aberhe-eng/SkyEar/images/pcb/pcb_3d_bottom.png

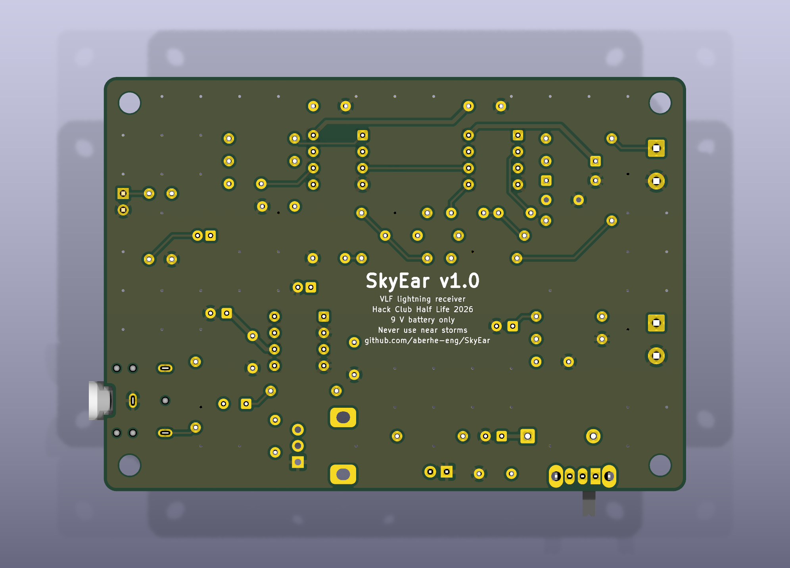
images/pcb/pcb_3d_bottom.png
