aberhe-eng/SkyEar/BOM.csv

Item | Qty | Supplier | Cost/item | Total Cost | link
Resistor 4.7k ohm 1/4W - YAGEO MFR-25FBF52-4K7 | 2 | DigiKey | $0.11 | $0.22 | https://www.digikey.com/en/products/result?keywords=MFR-25FBF52-4K7-ND
Resistor 10k ohm 1/4W - YAGEO MFR-25FBF52-10K | 10 | DigiKey | $0.04 | $0.40 | https://www.digikey.com/en/products/result?keywords=10.0KXBK-ND
Resistor 10M ohm (10 megohm) 1/4W - Stackpole CF14JT10M0 | 2 | DigiKey | $0.10 | $0.20 | https://www.digikey.com/en/products/result?keywords=CF14JT10M0CT-ND
Resistor 18k ohm 1/4W - YAGEO MFR-25FBF52-18K | 2 | DigiKey | $0.10 | $0.20 | https://www.digikey.com/en/products/result?keywords=MFR-25FBF52-18K-ND
Resistor 36k ohm 1/4W - YAGEO MFR-25FBF52-36K | 2 | DigiKey | $0.10 | $0.20 | https://www.digikey.com/en/products/result?keywords=13-MFR-25FBF52-36K-ND
Resistor 100k ohm 1/4W - YAGEO MFR-25FBF52-100K | 3 | DigiKey | $0.10 | $0.30 | https://www.digikey.com/en/products/result?keywords=100KXBK-ND
Resistor 3.3k ohm 1/4W - YAGEO MFR-25FBF52-3K3 | 2 | DigiKey | $0.10 | $0.20 | https://www.digikey.com/en/products/result?keywords=MFR-25FBF52-3K3-ND
Resistor 1k ohm 1/4W - YAGEO MFR-25FBF52-1K | 2 | DigiKey | $0.10 | $0.20 | https://www.digikey.com/en/products/result?keywords=1.00KXBK-ND
Resistor 10 ohm 1/4W - YAGEO MFR-25FBF52-10R | 2 | DigiKey | $0.10 | $0.20 | https://www.digikey.com/en/products/result?keywords=10.0XBK-ND
Resistor 47 ohm 1/4W - YAGEO MFR-25FBF52-47R | 2 | DigiKey | $0.10 | $0.20 | https://www.digikey.com/en/products/result?keywords=MFR-25FBF52-47R-ND
Electrolytic capacitor 100uF 25V - Panasonic ECA-1EM101I | 3 | DigiKey | $0.35 | $1.05 | https://www.digikey.com/en/products/result?keywords=10-ECA-1EM101ICT-ND
Ceramic capacitor 100nF 50V - TDK FG28X7R1H104KNT00 | 10 | DigiKey | $0.14 | $1.40 | https://www.digikey.com/en/products/result?keywords=445-FG28X7R1H104KNT00-ND
Electrolytic capacitor 47uF 50V - Panasonic ECA-1HM470 | 2 | DigiKey | $0.33 | $0.66 | https://www.digikey.com/en/products/result?keywords=P5181-ND
Ceramic capacitor 22pF 100V (C5 spare, not fitted) - TDK FG28C0G2A220JNT00 | 1 | DigiKey | $0.26 | $0.26 | https://www.digikey.com/en/products/result?keywords=445-175549-ND
Ceramic capacitor 10nF 50V C0G - TDK FG28C0G1H103JNT00 | 3 | DigiKey | $0.35 | $1.05 | https://www.digikey.com/en/products/result?keywords=FG28C0G1H103JNT00-ND
Ceramic capacitor 150pF 50V C0G - TDK FG28C0G1H151JNT00 | 2 | DigiKey | $0.22 | $0.44 | https://www.digikey.com/en/products/result?keywords=445-181753-ND
Ceramic capacitor 1uF 25V - TDK FG28X7R1E105KRT00 | 3 | DigiKey | $0.31 | $0.93 | https://www.digikey.com/en/products/result?keywords=445-181761-ND
Ceramic capacitor 2.2nF 50V C0G - TDK FG28C0G1H222JNT00 | 2 | DigiKey | $0.27 | $0.54 | https://www.digikey.com/en/products/result?keywords=445-FG28C0G1H222JNT00-ND
Ceramic capacitor 1nF 50V C0G - TDK FG28C0G1H102JNT00 | 2 | DigiKey | $0.25 | $0.50 | https://www.digikey.com/en/products/result?keywords=445-FG28C0G1H102JNT00-ND
Electrolytic capacitor 10uF 50V - KEMET ESK106M050AC3AA | 3 | DigiKey | $0.19 | $0.57 | https://www.digikey.com/en/products/result?keywords=399-6599-ND
Ceramic capacitor 47nF 50V - TDK FG28X7R1H473KNT00 | 2 | DigiKey | $0.23 | $0.46 | https://www.digikey.com/en/products/result?keywords=445-FG28X7R1H473KNT00-ND
Electrolytic capacitor 220uF 25V - Nichicon UVZ1E221MPD | 2 | DigiKey | $0.44 | $0.88 | https://www.digikey.com/en/products/result?keywords=493-1302-ND
Schottky diode 1N5817 (reverse-battery protection) - onsemi 1N5817G | 2 | DigiKey | $0.67 | $1.34 | https://www.digikey.com/en/products/result?keywords=1N5817GOS-ND
Red 5 mm LED (power light) - Kingbright WP7113ID | 2 | DigiKey | $0.21 | $0.42 | https://www.digikey.com/en/products/result?keywords=754-1264-ND
Diode 1N4148 (antenna input protection) - onsemi 1N4148 | 4 | DigiKey | $0.10 | $0.40 | https://www.digikey.com/en/products/result?keywords=1N4148FS-ND
TL072 dual JFET op-amp, DIP-8 - Texas Instruments TL072ACP | 3 | DigiKey | $1.50 | $4.50 | https://www.digikey.com/en/products/result?keywords=296-7190-5-ND
LM386 headphone amplifier, DIP-8 - Texas Instruments LM386N-1/NOPB | 2 | DigiKey | $1.18 | $2.36 | https://www.digikey.com/en/products/result?keywords=296-44414-5-ND
2-pin screw terminal 5.08 mm (battery, antenna) - Phoenix Contact 1715721 | 2 | DigiKey | $1.16 | $2.32 | https://www.digikey.com/en/products/result?keywords=277-1263-ND
3.5 mm headphone jack - Same Sky (CUI) SJ1-3523N | 1 | DigiKey | $1.12 | $1.12 | https://www.digikey.com/en/products/result?keywords=CP1-3523N-ND
2-pin header 2.54 mm (line out) - Sullins PREC002SAAN-RC | 1 | DigiKey | $0.10 | $0.10 | https://www.digikey.com/en/products/result?keywords=35-PREC002SAAN-RC-ND
Slide switch SPDT right-angle (power) - C&K OS102011MA1QN1 | 1 | DigiKey | $0.75 | $0.75 | https://www.digikey.com/en/products/result?keywords=CKN9559-ND
10k potentiometer (volume) - Alps Alpine RK09K1130AP5 | 1 | DigiKey | $1.70 | $1.70 | https://www.digikey.com/en/products/result?keywords=4809-RK09K1130AP5-ND
9V battery snap clip - Keystone 232 | 1 | DigiKey | $0.66 | $0.66 | https://www.digikey.com/en/products/result?keywords=36-232-ND
DIP-8 IC socket - Mill-Max 110-44-308-41-001000 | 3 | DigiKey | $0.99 | $2.97 | https://www.digikey.com/en/products/result?keywords=ED90048-ND
SkyEar PCB v1.0: 2-layer FR-4, 1.6 mm, 90 x 64 mm (Gerbers in pcb/gerbers) | 5 | JLCPCB | $0.40 | $2.00 | https://jlcpcb.com/quote
Estimated total shipping | 1 |  |  | $20.00
