aberhe-eng/SkyEar/JOURNAL.md

# Sky-Ear – devlog

<!-- Generated by Half Life from project cmuwsvtv10air01osvt94v5qg. Edits here are overwritten on the next sync. -->
<!-- Generated: 2026-10-11T19:29:52.596Z -->

> [!NOTE]
> This devlog is mirrored from [Half Life](https://halflife.hackclub.com) – [open the project](https://halflife.hackclub.com/projects/cmuwsvtv10air01osvt94v5qg). Editing it here will not change the platform's copy, and the next sync overwrites this file.

> A pocket radio that listens to lightning strikes thousands of miles away, plus the eerie whistling sounds lightning makes after bouncing along Earth's magnetic field through space. Basically a phone call from the planet.

| Week | Tier | Hours logged | Entries |
| --- | --- | --- | --- |
| Week 1 | Tier 2 | 28h | 2 |

## Contents

1. [2026-10-07 – I spent the first 3 hours learning how to use KiCad, specifically it's schematic editor. I followed a tutorial on building a beginner project, and learned how to use the editor along the way. The desi](#2026-10-07-i-spent-the-first-3-hours-learning-how-to-use-kic)
2. [2026-10-11 – This session was all about getting SkyEar's complete schematic into KiCad, which is the core of my Week 1 PCB design. Since my build guide already had every part, value and connection worked out block](#2026-10-11-this-session-was-all-about-getting-skyears-comple)

## Design

### 2026-10-07 – I spent the first 3 hours learning how to use KiCad, specifically it's schematic editor. I followed a tutorial on building a beginner project, and learned how to use the editor along the way. The desi

**13h**

I spent the first 3 hours learning how to use KiCad, specifically it's schematic editor. I followed a tutorial on building a beginner project, and learned how to use the editor along the way. The design in the image (which is the project from the tutorial) is based on the LM555 timer, which can blink a LED with a frequency that can be adjusted by the trimmer. This project let me understand the basics of making circuits, such as GND, Resistors, mounting holes, power sources, etc.





I then spent the remaining 10 hours drafting a full PDF for the SkyEar Project. The document includes a detailed parts list, the overall design of SkyEar, and small diagrams to help me understand how each section of the circuit connects together before I start drawing the final schematic.

SkyEar is divided into seven main blocks: power, virtual ground (VREF), antenna buffer, hum filter, gain stage, high-frequency filter, and outputs. Breaking the project into these blocks helped me understand the purpose of each part of the circuit instead of treating the entire schematic as one complicated design.

















I then spent some time doing more beginner projects, like a tutorial for making a traffic light:https://www.youtube.com/watch?v=EPH23zhPg50



I then learned how to make a 3D model of this schematic, which I have never done before. It took me a while but I eventually got the hang of it. I plan to do more projects learning how to use the 3D modeling tool





### 2026-10-11 – This session was all about getting SkyEar's complete schematic into KiCad, which is the core of my Week 1 PCB design. Since my build guide already had every part, value and connection worked out block

**15h**

This session was all about getting SkyEar's complete schematic into KiCad, which is the core of my Week 1 PCB design. Since my build guide already had every part, value and connection worked out block by block, I made the KiCad schematic directly from it. It came out as a single sheet with 52 parts, split into labeled sections that follow the signal from the antenna all the way to the headphones, and every part already has a real KiCad footprint assigned so it's ready for the PCB editor.





The power section takes a 9 V battery through a screw terminal (J1) and a slide switch (SW1), then through a 1N5817 Schottky diode (D1). The diode means plugging the battery in backwards can't fry anything, and I picked a Schottky because it only drops about 0.3 V instead of 0.7 V like a normal diode. C1 (100 µF) and C2 (100 nF) smooth out the supply, and a 4.7k resistor feeds a power LED at about 1.5 mA. Next to it is the virtual ground: two 10k resistors split the battery in half to make a ~4.35 V "VREF", with C3 and C4 keeping it quiet. Audio signals swing both above and below zero, but a single battery only gives 0 V and +9 V, so every op-amp signal swings around VREF instead.





The antenna input was the most interesting part to understand. A short wire antenna behaves like a tiny ~30 pF capacitor, so it can barely push any current. That's why R5 is 10 MΩ instead of a normal 10k, and why the first stage (U1A, half of a TL072) is a buffer that just copies the signal without loading it. The TL072 has JFET inputs, which is what lets it handle such a high resistance. R5 and the antenna capacitance also form the first filter, starting to cut hum below ~530 Hz. R4 and two 1N4148 diodes (D3, D4) protect the input by dumping static from the antenna into the power rails. C5 is marked "do not fit" and only gets soldered if I end up hearing AM radio.







After the buffer comes the hum filter (U1B), a 2nd-order high-pass at about 625 Hz built from two 10 nF caps, an 18k and a 36k. Making the 36k exactly twice the 18k gives a flat Butterworth response with no bump at the cutoff. Power lines put out 60 Hz hum that's thousands of times stronger than lightning on another continent, so this filter is what makes the whole thing usable. Then U2A amplifies the signal by 1 + 100k/3.3k ≈ 31. C9 keeps DC from getting amplified so the output stays centered on VREF, and C8 (150 pF) starts rolling off the highs. U2B is a 2nd-order low-pass at ~10.7 kHz that cuts hiss, AM radio, and the Navy's huge VLF transmitters around 20 to 25 kHz, which could otherwise overload everything.







The output splits two ways. The line out (J4) goes through a 10 µF cap and a 1k resistor so I can record the audio or feed it into my later Half Life projects. The headphone path goes through a 10k audio-taper volume knob (RV1) into an LM386 amp that adds another x20, so the total gain from antenna to ears is around 620. R14 and C17 (10 Ω + 47 nF) keep the LM386 from oscillating, C18 (220 µF) blocks DC from reaching my headphones, and R15 (47 Ω) caps the maximum volume so it can't blast my ears. Tip and ring on the jack are tied together so the mono signal goes to both ears.





For checking, the schematic passed KiCad's Electrical Rules Checker with 0 errors, every one of the 27 nets was compared against my guide, every footprint's pads were matched to its symbol's pins (the headphone jack's T/R/S pads were the one I was most worried about), and every electrolytic cap was checked to have its + side on the higher voltage. The project file also already has my track widths set: 0.6 mm for +9V and GND, and 0.3 mm for signals. [What you did yourself, e.g. "I opened it in KiCad on my own computer, re-ran the checker, fixed the 2 library warnings KiCad 10 shows with Update Symbols from Library, and traced the signal from J2 to J3 against my guide."]







One thing I still need to figure out is the budget. Tier 1 is $30 and my rough estimate is $35 to $50 once the PCB and the antenna are included, so my next step is pricing the real BOM. After that comes the PCB layout, where the main rule is keeping the antenna input as far as possible from the headphone amp so the loud output can't leak back into the input and squeal.
