aberhe-eng/SkyEar/pcb/skyear_schematic.pdf

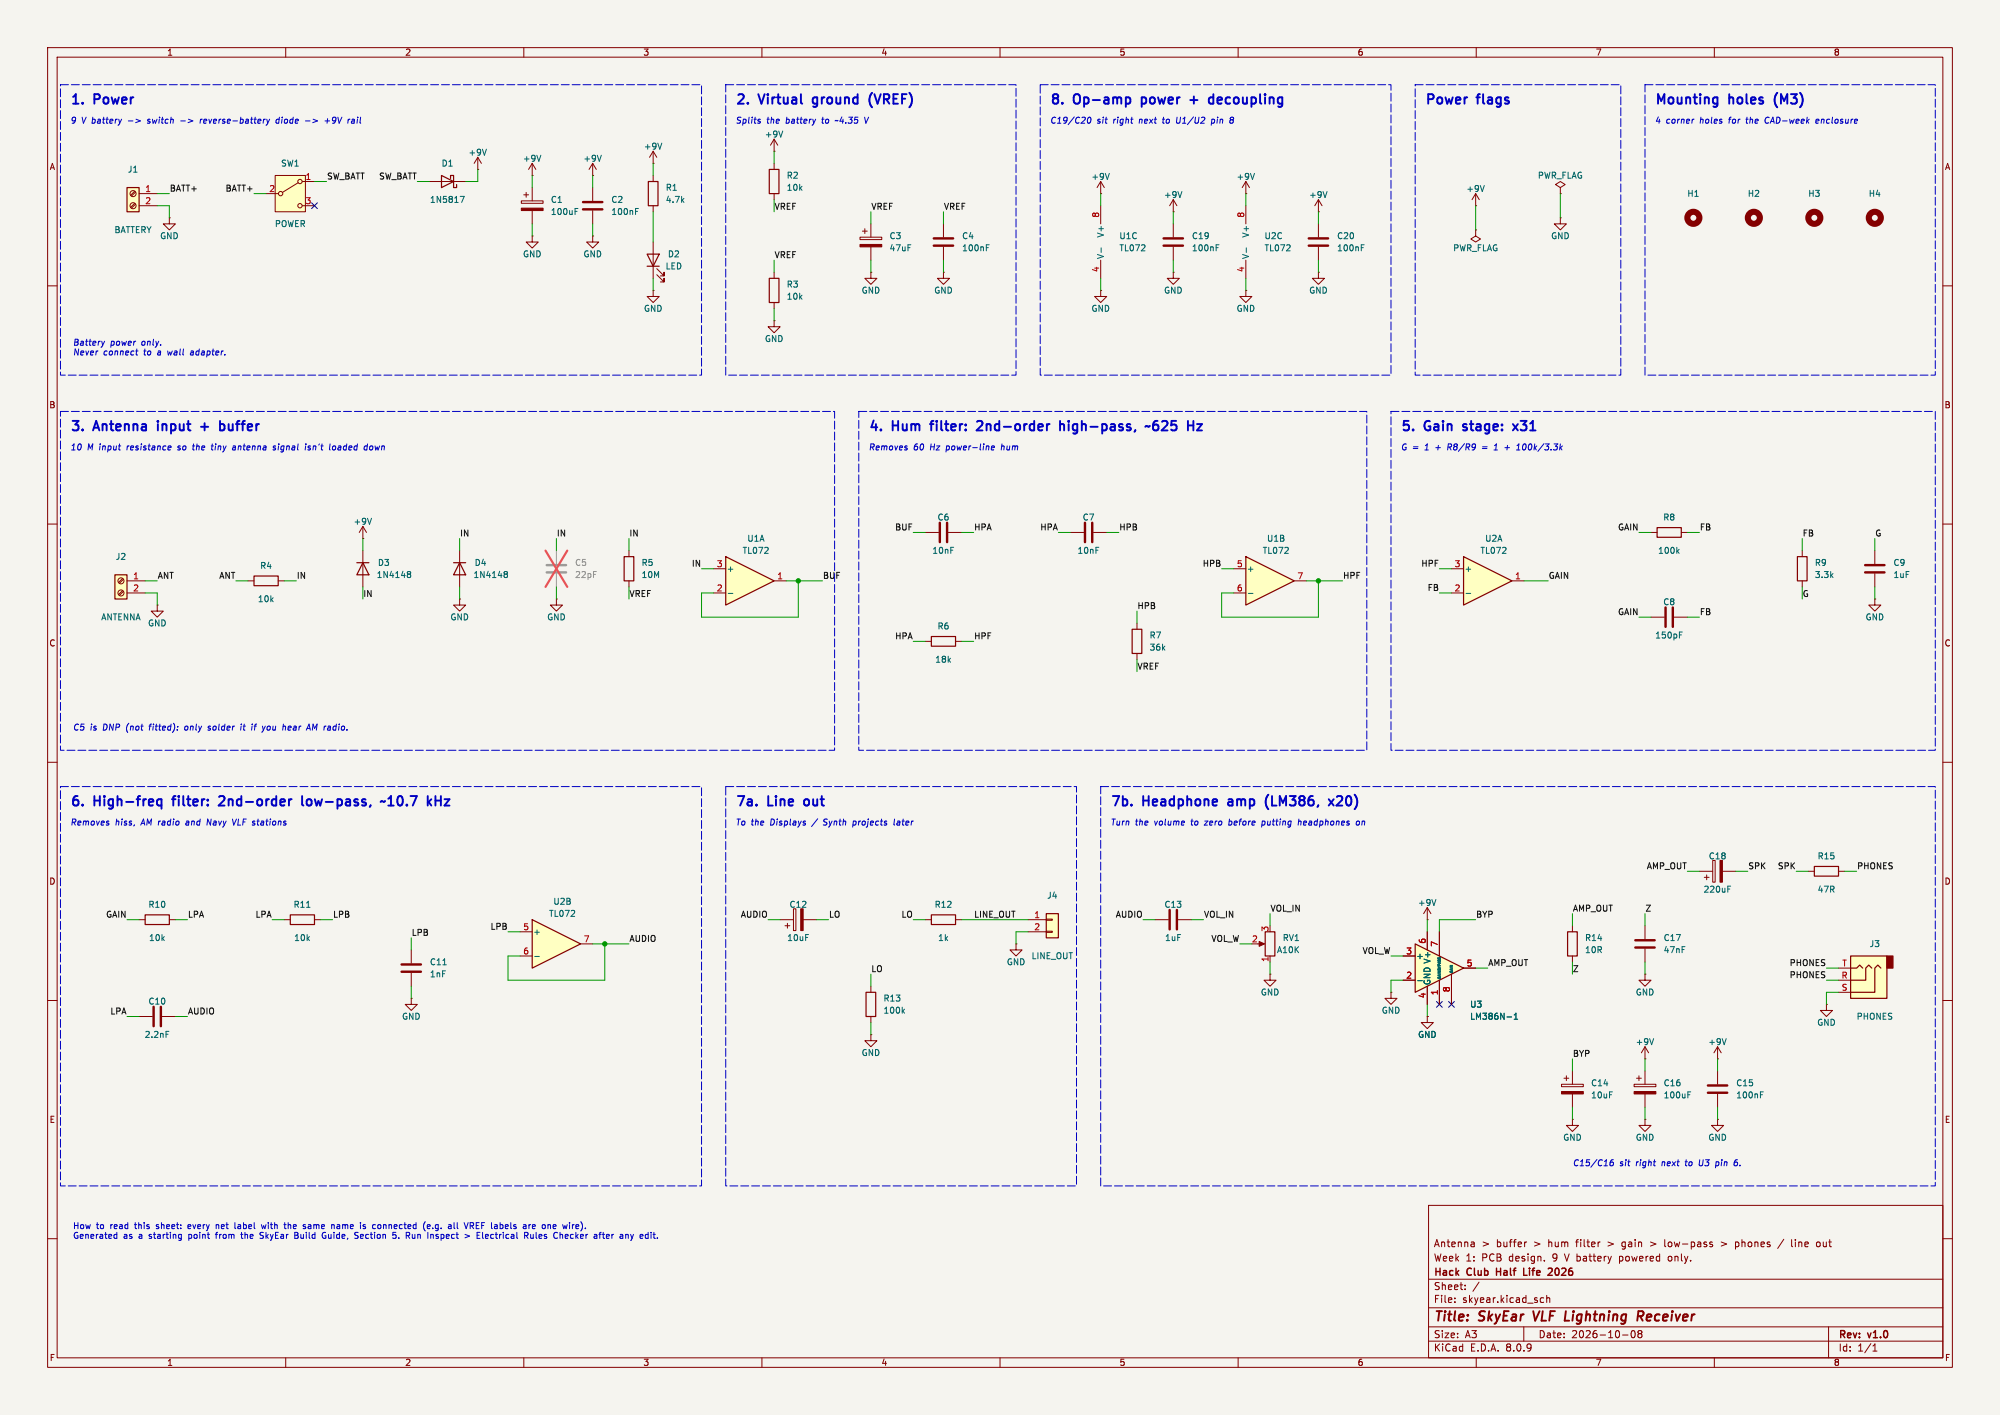
[picture p21: page 1]

Splits the battery to ~4.35 V 2. Virtual ground (VREF)

Battery power only. Never connect to a wall adapter.
