aberhe-eng/SkyEar/pcb/skyear.kicad_pcb

## KiCad design pcb/skyear.kicad_pcb (2026-10-11)

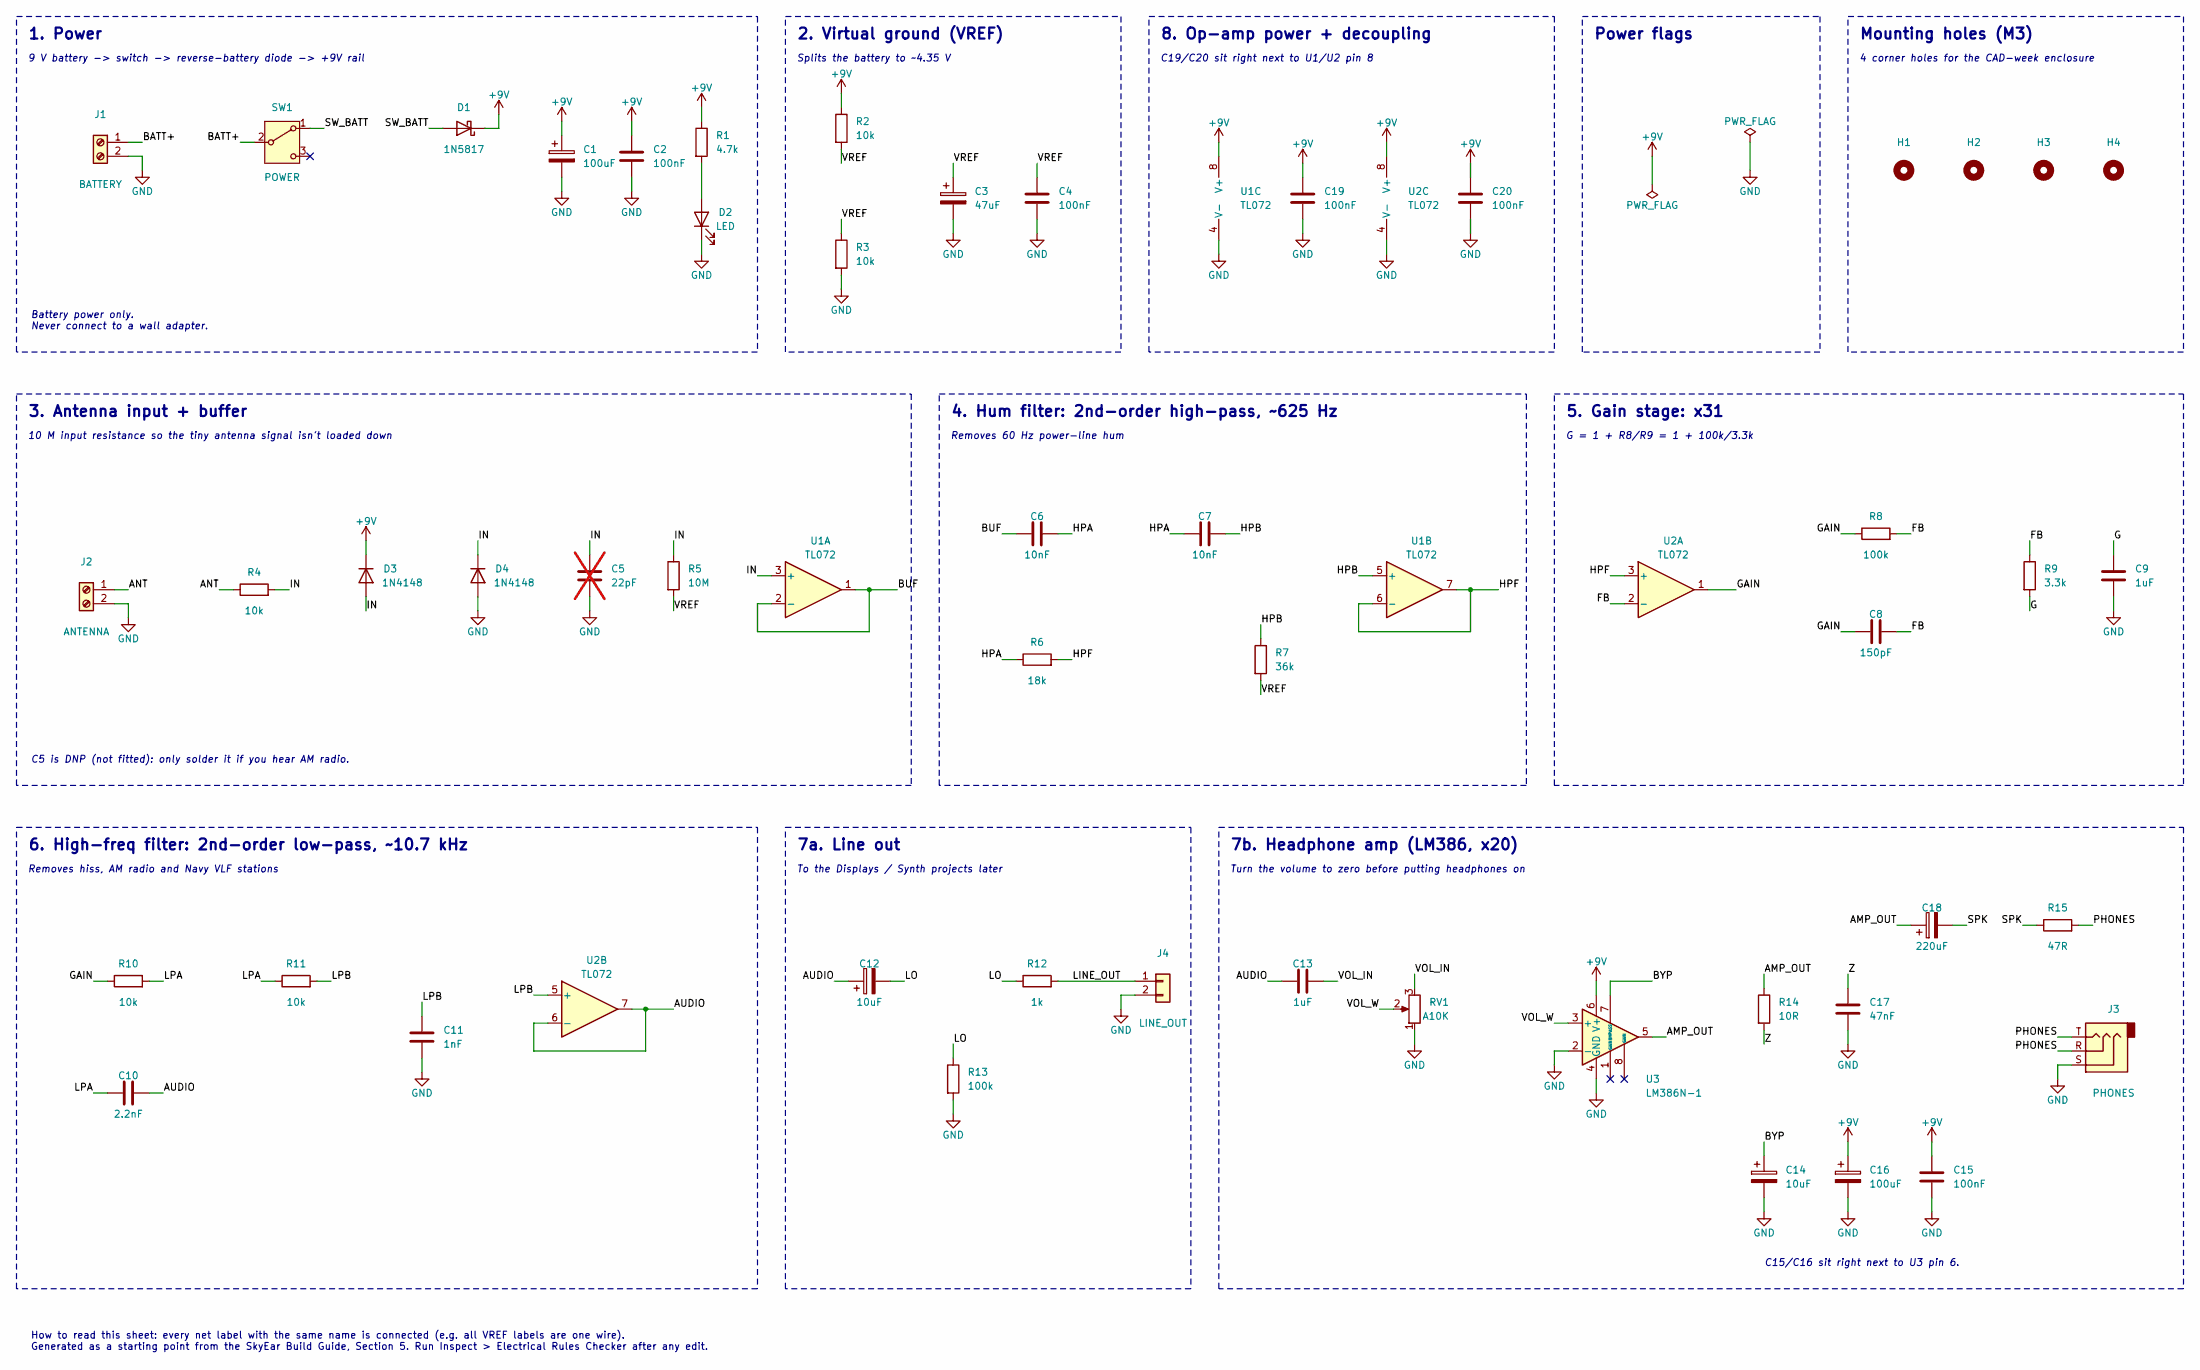
[picture p22: schematic skyear.kicad_sch, SkyEar VLF Lightning Receiver]

Parts:
C1, C16: 100uF; CP_Radial_D6.3mm_P2.50mm
C2, C4, C15, C19, C20: 100nF; C_Disc_D5.0mm_W2.5mm_P5.00mm
C3: 47uF; CP_Radial_D6.3mm_P2.50mm
C5: 22pF; C_Disc_D5.0mm_W2.5mm_P5.00mm; not fitted
C6, C7: 10nF; C_Disc_D5.0mm_W2.5mm_P5.00mm
C8: 150pF; C_Disc_D5.0mm_W2.5mm_P5.00mm
C9, C13: 1uF; C_Disc_D5.0mm_W2.5mm_P5.00mm
C10: 2.2nF; C_Disc_D5.0mm_W2.5mm_P5.00mm
C11: 1nF; C_Disc_D5.0mm_W2.5mm_P5.00mm
C12, C14: 10uF; CP_Radial_D5.0mm_P2.00mm
C17: 47nF; C_Disc_D5.0mm_W2.5mm_P5.00mm
C18: 220uF; CP_Radial_D8.0mm_P3.50mm
D1: 1N5817; D_DO-41_SOD81_P10.16mm_Horizontal
D2: LED; LED_D5.0mm
D3, D4: 1N4148; D_DO-35_SOD27_P7.62mm_Horizontal
H1, H2, H3, H4: MountingHole; MountingHole_3.2mm_M3
J1: BATTERY; TerminalBlock_Phoenix_MKDS-1,5-2-5.08_1x02_P5.08mm_Horizont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; MPN Phoenix MKDS 1,5/2-5,08 (or same 5.08 m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
J2: ANTENNA; TerminalBlock_Phoenix_MKDS-1,5-2-5.08_1x02_P5.08mm_Horizont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; MPN Phoenix MKDS 1,5/2-5,08 (or same 5.08 m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
J3: PHONES; Jack_3.5mm_CUI_SJ1-3523N_Horizontal; MPN CUI SJ1-3523N
J4: LINE_OUT; PinHeader_1x02_P2.54mm_Vertical
R1: 4.7k; R_Axial_DIN0207_L6.3mm_D2.5mm_P10.16mm_Horizontal
R2, R3, R4, R10, R11: 10k; R_Axial_DIN0207_L6.3mm_D2.5mm_P10.16mm_Horizontal
R5: 10M; R_Axial_DIN0207_L6.3mm_D2.5mm_P10.16mm_Horizontal
R6: 18k; R_Axial_DIN0207_L6.3mm_D2.5mm_P10.16mm_Horizontal
R7: 36k; R_Axial_DIN0207_L6.3mm_D2.5mm_P10.16mm_Horizontal
R8, R13: 100k; R_Axial_DIN0207_L6.3mm_D2.5mm_P10.16mm_Horizontal
R9: 3.3k; R_Axial_DIN0207_L6.3mm_D2.5mm_P10.16mm_Horizontal
R12: 1k; R_Axial_DIN0207_L6.3mm_D2.5mm_P10.16mm_Horizontal
R14: 10R; R_Axial_DIN0207_L6.3mm_D2.5mm_P10.16mm_Horizontal
R15: 47R; R_Axial_DIN0207_L6.3mm_D2.5mm_P10.16mm_Horizontal
RV1: A10K; Potentiometer_Alps_RK09K_Single_Vertical; MPN Alps RK09K series, 10k audio (A) taper
SW1: POWER; SW_Slide_SPDT_Angled_CK_OS102011MA1Q; MPN C&K OS102011MA1QN1 (right-angle)
U1, U2: TL072; DIP-8_W7.62mm_Socket
U3: LM386N-1; DIP-8_W7.62mm_Socket

Connections:
+9V: C1.1, C2.1, C15.1, C16.1, C19.1, C20.1, D1.1 (K), D3.1 (K), R1.1, R2.1, U1.8 (V+), U2.8 (V+), U3.6 (V+)
/AMP_OUT: C18.1, R14.1, U3.5
/ANT: J2.1, R4.1
/AUDIO: C10.2, C12.1, C13.1, U2.6 (-), U2.7
/BATT+: J1.1, SW1.2 (B)
/BUF: C6.1, U1.1, U1.2 (-)
/BYP: C14.1, U3.7 (BYPASS)
/FB: C8.2, R8.2, R9.1, U2.2 (-)
/G: C9.1, R9.2
/GAIN: C8.1, R8.1, R10.1, U2.1
/HPA: C6.2, C7.1, R6.1
/HPB: C7.2, R7.1, U1.5 (+)
/HPF: R6.2, U1.6 (-), U1.7, U2.3 (+)
/IN: C5.1, D3.2 (A), D4.1 (K), R4.2, R5.1, U1.3 (+)
/LINE_OUT: J4.1, R12.2
/LO: C12.2, R12.1, R13.1
/LPA: C10.1, R10.2, R11.1
/LPB: C11.1, R11.2, U2.5 (+)
/PHONES: J3.R, J3.T, R15.2
/SPK: C18.2, R15.1
/SW_BATT: D1.2 (A), SW1.1 (A)
/VOL_IN: C13.2, RV1.3
/VOL_W: RV1.2, U3.3 (+)
/VREF: C3.1, C4.1, R2.2, R3.1, R5.2, R7.2
/Z: C17.1, R14.2
GND: C1.2, C2.2, C3.2, C4.2, C5.2, C9.2, C11.2, C14.2, C15.2, C16.2, C17.2, C19.2, C20.2, D2.1 (K), D4.2 (A), J1.2, J2.2, J3.S, J4.2, R3.2, R13.2, RV1.1, U1.4 (V-), U2.4 (V-), U3.2 (-), U3.4 (GND)
unnamed: D2.2 (A), R1.2

Notes on the sheet:
1. Power
9 V battery -> switch -> reverse-battery diode -> +9V rail
Battery power only. Never connect to a wall adapter.
2. Virtual ground (VREF)
Splits the battery to ~4.35 V
8. Op-amp power + decoupling
C19/C20 sit right next to U1/U2 pin 8
Power flags
Mounting holes (M3)
4 corner holes for the CAD-week enclosure
3. Antenna input + buffer
10 M input resistance so the tiny antenna signal isn't loaded down
C5 is DNP (not fitted): only solder it if you hear AM radio.
4. Hum filter: 2nd-order high-pass, ~625 Hz
Removes 60 Hz power-line hum
5. Gain stage: x31
G = 1 + R8/R9 = 1 + 100k/3.3k
6. High-freq filter: 2nd-order low-pass, ~10.7 kHz
Removes hiss, AM radio and Navy VLF stations
7a. Line out
To the Displays / Synth projects later
7b. Headphone amp (LM386, x20)
Turn the volume to zero before putting headphones on
C15/C16 sit right next to U3 pin 6.
How to read this sheet: every net label with the same name is connected (e.g. all VREF labels are one wire). Generated as a starting point from the SkyEar Build Guide, Section 5. Run Inspect > Electrical Rules Checker after any edit.

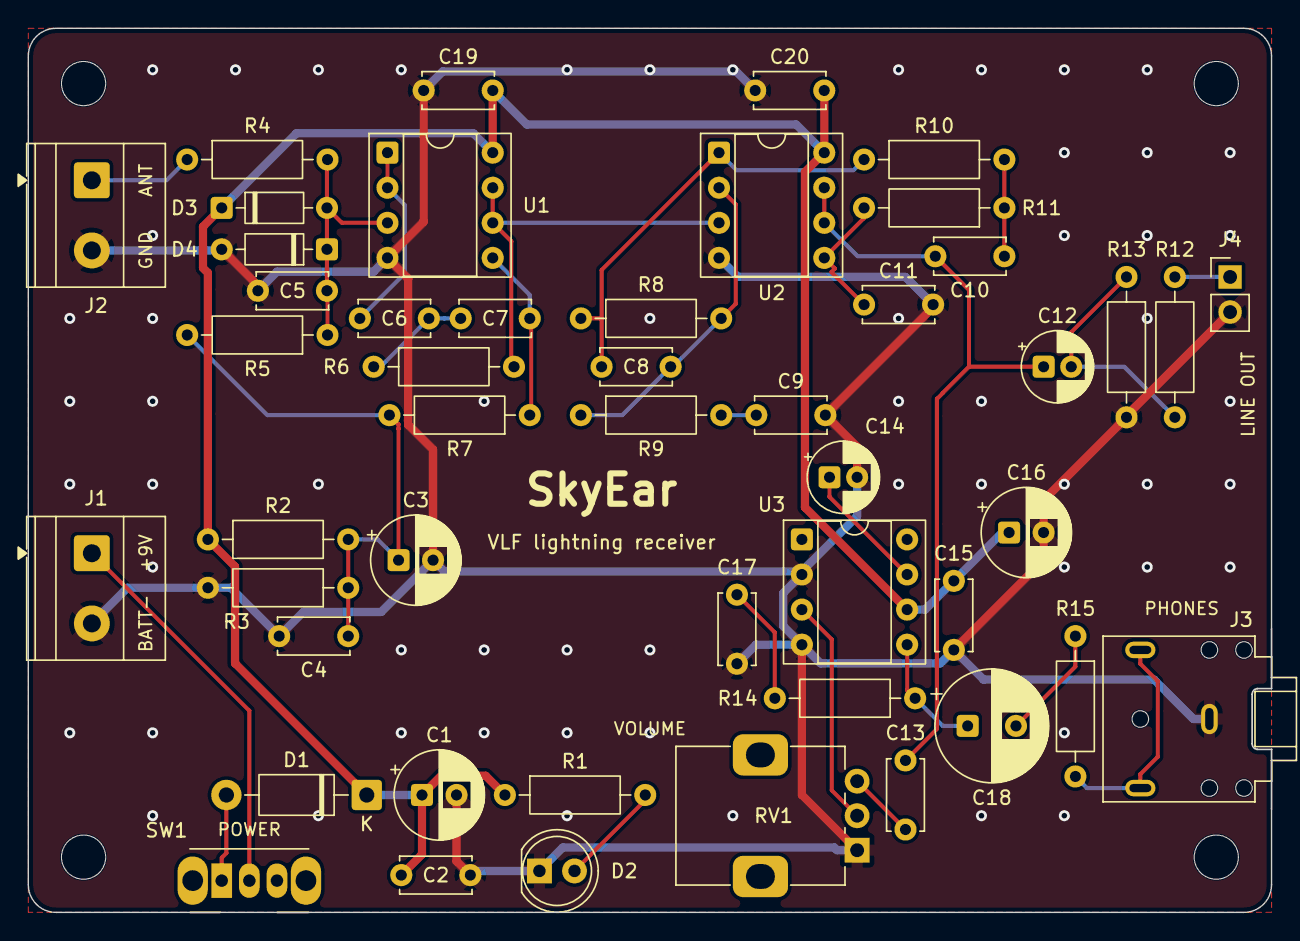
[picture p23: board skyear.kicad_pcb from above]

Board: 2 copper layers, 90.0 x 64.0 mm, 52 parts (0 on the bottom side), 27 nets.
