aberhe-eng/SkyEar/(commit log)

2026-10-11 Add README, KiCad schematic, images and BOM
    - README.md: what SkyEar is, how each stage works, specs, status, safety
    - images/: block diagram, full schematic render, and KiCad screenshots
    - pcb/: KiCad project, schematic and PDF copy
    - bom.csv: full parts list with footprints, plus off-board items
    [bom.csv, skyear.kicad_sch]
2026-10-11 Add README, KiCad schematic, images and BOM
    Claude-Session: https://claude.ai/code/session_017gCygh5QrYo9QD1FT88DS2
    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
    [bom.csv, skyear.kicad_sch]
2026-10-11 Use real DigiKey parts in BOM; switch SW1 to right-angle footprint
    - bom.csv: every line now has the DigiKey part number and price from the
    actual cart (34 lines, $29.67 parts subtotal). Obsolete Nichicon caps and
    backordered parts were replaced with in-stock equivalents in the same sizes.
    - SW1: the switch in the cart is the right-angle C&K OS102011MA1QN1, so the
    footprint is now SW_Slide_SPDT_Angled_CK_OS102011MA1Q (same pins 1/2/3).
    ERC: 0 errors; netlist and footprint pads re-verified.
    [bom.csv, skyear.kicad_sch]
2026-10-11 Add PCB layout, Gerbers and import-ready BOM
    - pcb/skyear.kicad_pcb: 90 x 64 mm 2-layer board, routed, GND pours on both
    layers; KiCad DRC 0 errors, 0 unconnected, 0 schematic mismatches
    - pcb/gerbers + pcb/skyear_gerbers_jlcpcb.zip: JLCPCB-ready fab files
    - images/pcb: 3D renders and Gerber renders
    - bom.csv: Part/Qty/Unit/Total/Vendor/Link columns, adds the PCB line
    - README: PCB section, updated status and parts total
    [bom.csv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]
2026-10-16 Sync Sky-Ear from Half Life
    [BOM.csv]
